mignon-p/NeoBit/doc/neobit-butterfly.jpg

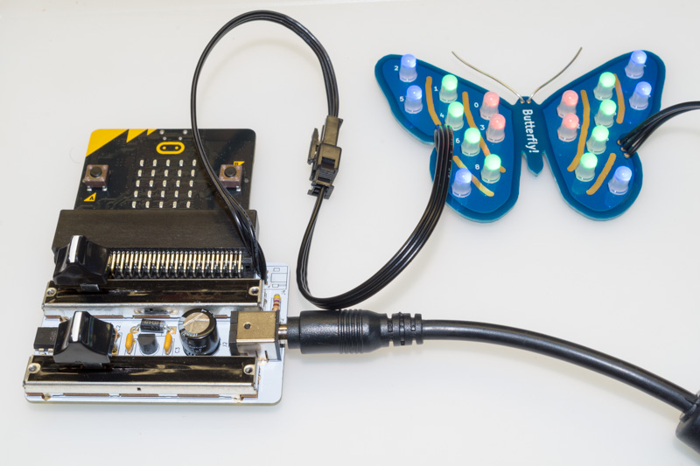
doc/neobit-butterfly.jpg
