mignon-p/NeoBit/doc/schematic.pdf

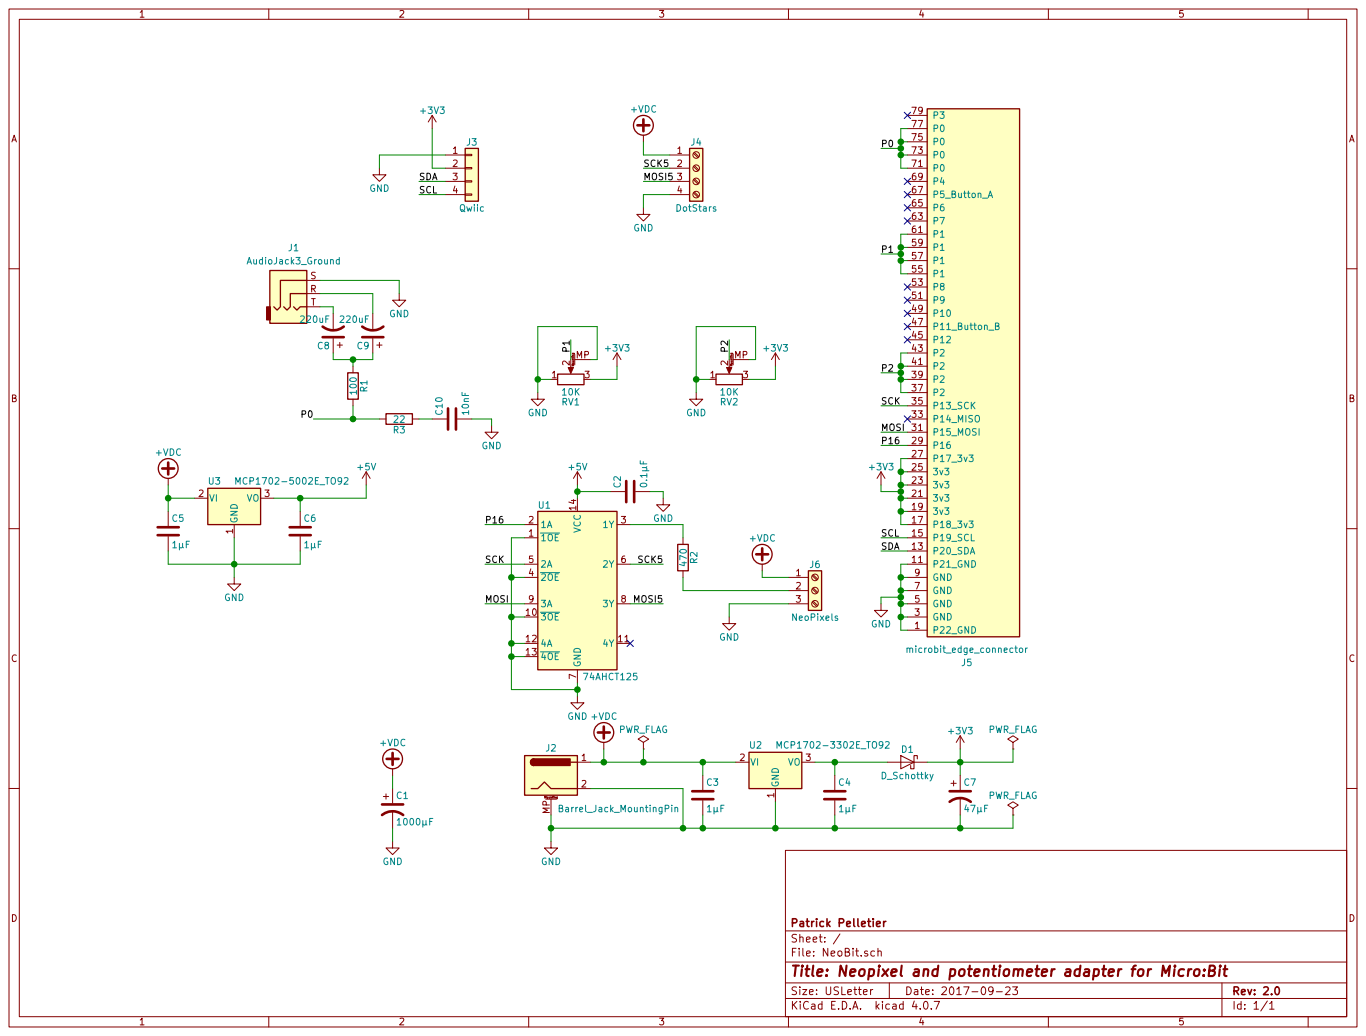
[picture p7: page 1]
