mignon-p/NeoBit/NeoBit.kicad_pcb

## KiCad design NeoBit.kicad_pcb (2018-09-23)

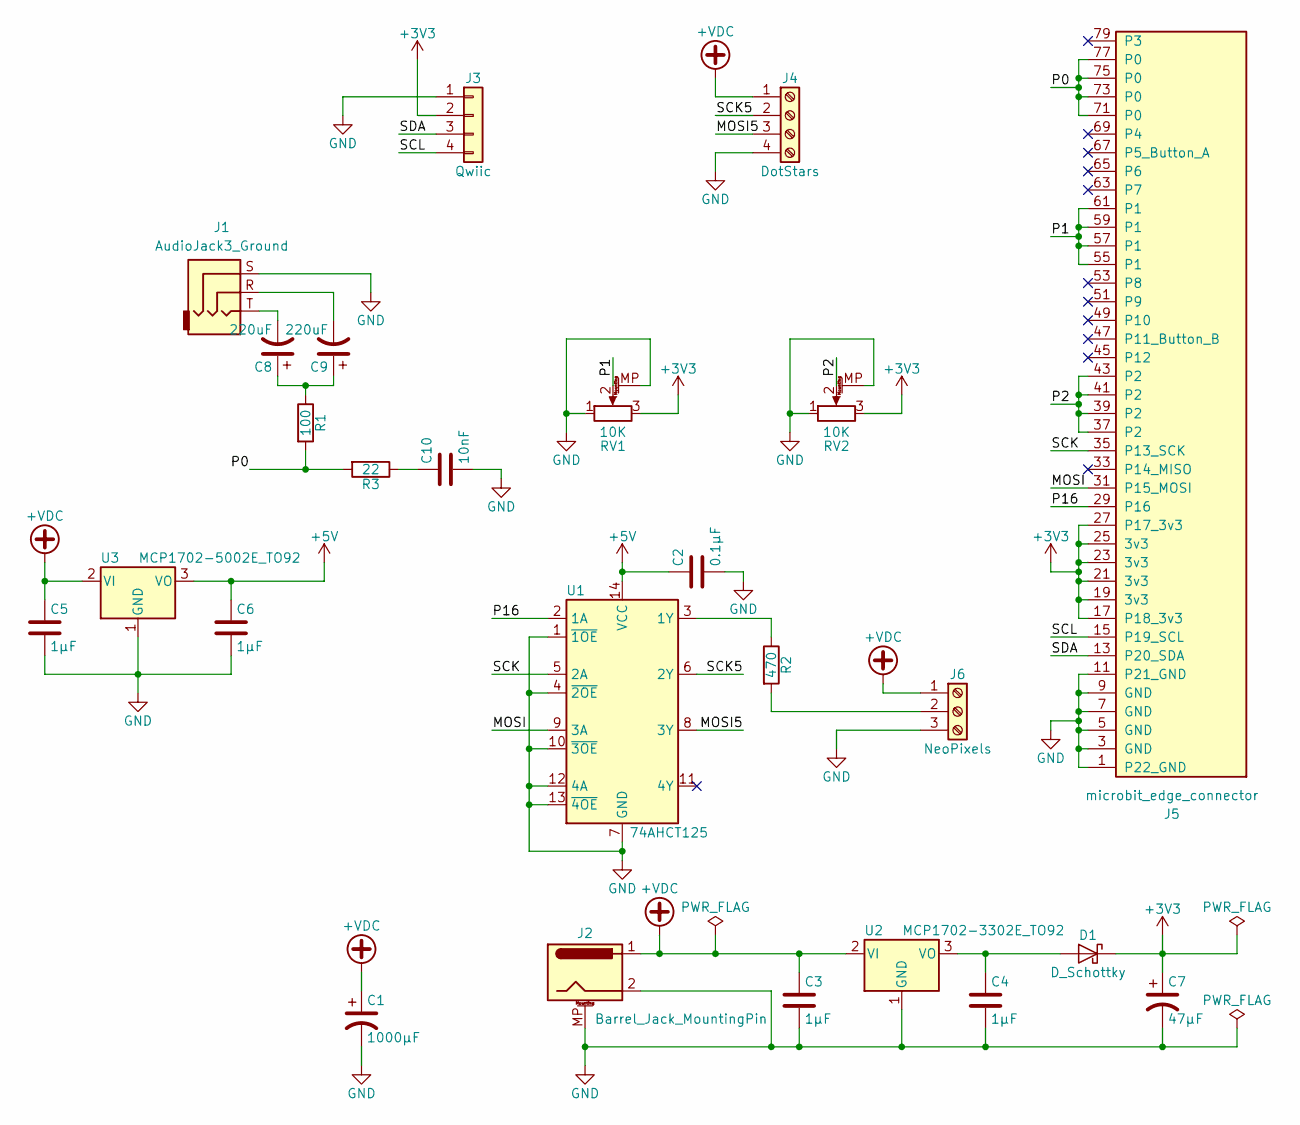
[picture p8: schematic NeoBit.sch, Neopixel and potentiometer adapter for Micro:Bit]

Parts:
C1: 1000µF; CP_Radial_D10.0mm_P5.00mm; MPN 25PX1000MEFCT810X16; Digi-Key_PN 1189-1583-1-ND
C2: 0.1µF; C_Rect_L7.0mm_W2.5mm_P5.00mm; MPN K104K10X7RF5UH5; Digi-Key_PN BC2665CT-ND
C3, C4, C5, C6: 1µF; C_Rect_L7.0mm_W2.5mm_P5.00mm; MPN K105Z20Y5VF5TH5; Digi-Key_PN BC1168CT-ND
C7: 47µF; CP_Radial_D6.3mm_P2.50mm; MPN ECE-A1CKS470; Digi-Key_PN P969-ND
C8, C9: 220uF; CP_Radial_D5.0mm_P2.50mm; MPN UVK1A221MDD1TD; Digi-Key_PN 493-7455-1-ND
C10: 10nF; C_Disc_D3.8mm_W2.6mm_P2.50mm; MPN K103K15X7RF5TL2; Digi-Key_PN BC1078CT-ND
D1: D_Schottky; D_DO-41_SOD81_P7.62mm_Horizontal; MPN 1N5817; Digi-Key_PN 1N5817FSCT-ND
J1: AudioJack3_Ground; SJ1-3533NG; MPN SJ1-3533NG; Digi-Key_PN CP1-3533NG-ND
J2: Barrel_Jack_MountingPin; BarrelJack_CUI_PJ-063AH_Horizontal_CircularHoles; MPN PJ-063AH; Digi-Key_PN CP-063AH-ND
J3: Qwiic; JST_SH_SM04B-SRSS-TB_04x1.00mm_Angled; MPN PRT-14417
J4: DotStars; TerminalBlock_4Ucon_1x04_P3.50mm_Vertical; MPN 1776275-4; Digi-Key_PN A98038-ND
J5: microbit_edge_connector; 4UCON_10156_2x40_P1.27mm_Socket_Horizontal; MPN 3342
J6: NeoPixels; TerminalBlock_4Ucon_1x03_P3.50mm_Vertical; MPN 1776275-3; Digi-Key_PN A98037-ND
R1: 100; R_Axial_DIN0207_L6.3mm_D2.5mm_P2.54mm_Vertical
R2: 470; R_Axial_DIN0207_L6.3mm_D2.5mm_P2.54mm_Vertical; MPN CF14JT470R; Digi-Key_PN CF14JT470RCT-ND
R3: 22; R_Axial_DIN0207_L6.3mm_D2.5mm_P2.54mm_Vertical
RV1, RV2: 10K; Bourns_PTA4543; MPN PTA4553-2015CPB103; Digi-Key_PN PTA4553-2015CPB103-ND
U1: 74AHCT125; DIP-14_W7.62mm; MPN SN74AHCT125N; Digi-Key_PN 296-4655-5-ND
U2: MCP1702-3302E_TO92; TO-92_Inline_Narrow_Oval; MPN MCP1702-3302E/TO; Digi-Key_PN MCP1702-3302E/TO-ND
U3: MCP1702-5002E_TO92; TO-92_Inline_Narrow_Oval

Connections:
+3V3: C7.1, D1.1 (K), J3.2, J5.17 (P18_3v3), J5.19 (3v3), J5.21 (3v3), J5.23 (3v3), J5.25 (3v3), J5.27 (P17_3v3), RV1.3, RV2.3
+5V: C2.1, C6.1, U1.14 (VCC), U3.3 (VO)
+VDC: C1.1, C3.1, C5.1, J2.1, J4.1, J6.1, U2.2 (VI), U3.2 (VI)
/MOSI: J5.31 (P15_MOSI), U1.9 (3A)
/MOSI5: J4.3, U1.8 (3Y)
/P0: J5.71 (P0), J5.73 (P0), J5.75 (P0), J5.77 (P0), R1.2, R3.2
/P1: J5.55 (P1), J5.57 (P1), J5.59 (P1), J5.61 (P1), RV1.2
/P2: J5.37 (P2), J5.39 (P2), J5.41 (P2), J5.43 (P2), RV2.2
/P16: J5.29 (P16), U1.2 (1A)
/SCK: J5.35 (P13_SCK), U1.5 (2A)
/SCK5: J4.2, U1.6 (2Y)
/SCL: J3.4, J5.15 (P19_SCL)
/SDA: J3.3, J5.13 (P20_SDA)
GND: C1.2, C2.2, C3.2, C4.2, C5.2, C6.2, C7.2, C10.2, J1.S, J2.2, J2.MP (MountPin), J3.1, J4.4, J5.1 (P22_GND), J5.3 (GND), J5.5 (GND), J5.7 (GND), J5.9 (GND), J5.11 (P21_GND), J6.3, RV1.1, RV1.MP (MountPin), RV2.1, RV2.MP (MountPin), U1.1 (~1OE), U1.4 (~2OE), U1.7 (GND), U1.10 (~3OE), U1.12 (4A), U1.13 (~4OE), U2.1 (GND), U3.1 (GND)
unnamed: C4.1, D1.2 (A), U2.3 (VO)
unnamed: C8.1, C9.1, R1.1
unnamed: C8.2, J1.T
unnamed: C9.2, J1.R
unnamed: C10.1, R3.1
unnamed: J6.2, R2.2
unnamed: R2.1, U1.3 (1Y)

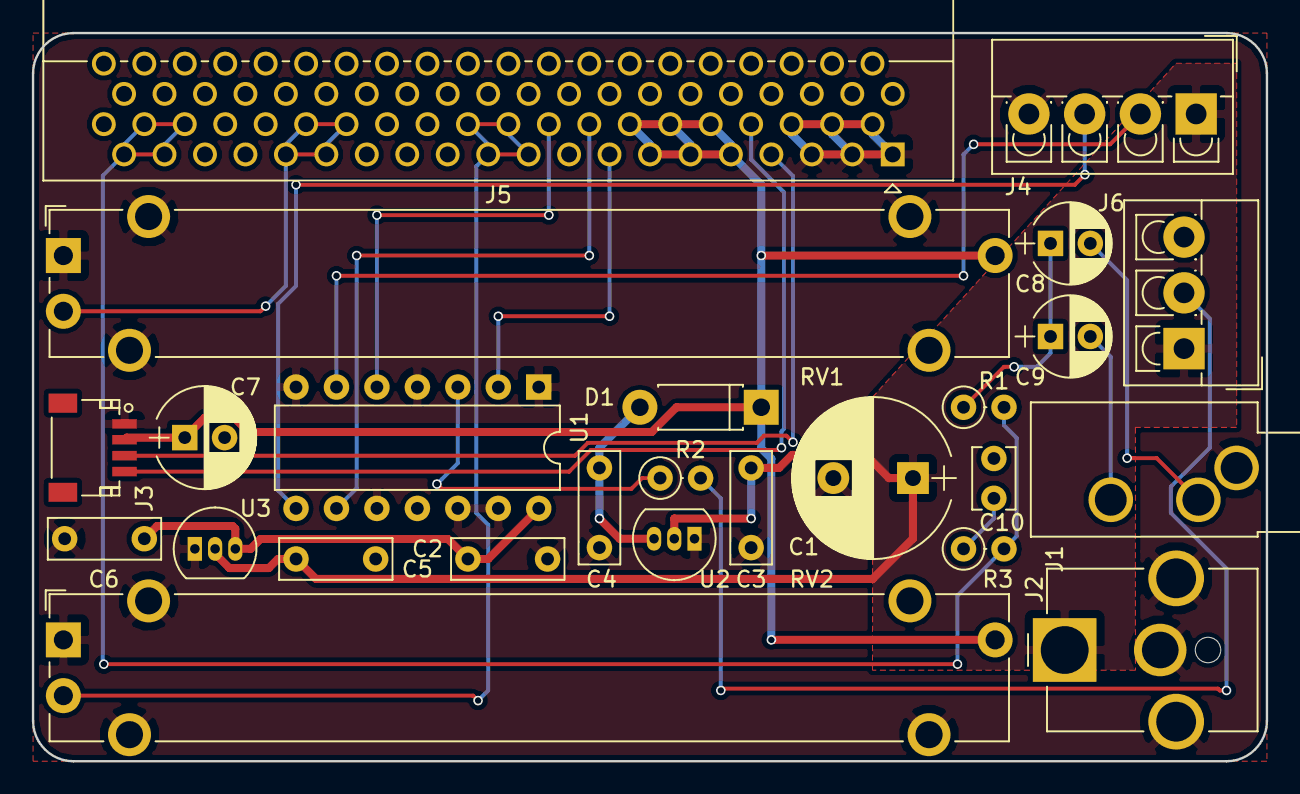
[picture p9: board NeoBit.kicad_pcb from above]

Board: 2 copper layers, 77.5 x 45.7 mm, 25 parts (0 on the bottom side), 21 nets.
