mignon-p/NeoBit/(commit log)

2018-08-30 Initial commit.
    [MicroBitFeather.kicad_pcb, MicroBitFeather.sch]
2018-08-30 Add component libraries.
    [MicroBitFeather.sch]
2018-08-30 Update pin size and fill of feather components.
    [MicroBitFeather.sch]
2018-08-30 Wire up the micro:bit and feather connectors.
    [MicroBitFeather.sch]
2018-08-30 Add connector for NeoPixels.
    [MicroBitFeather.sch]
2018-08-30 Library with a couple other random components.
2018-08-30 Align 74AHCT125 pins to grid.
    [MicroBitFeather.sch]
2018-08-30 Update symbol cache.
    [MicroBitFeather.sch]
2018-08-30 Wired some more things up.
    [MicroBitFeather.sch]
2018-08-30 Add voltage regulator and more.
    [MicroBitFeather.sch]
2018-08-31 Fill in manufacturer part numbers.
    [MicroBitFeather.sch]
2018-08-31 Decrease size of cap on 3.3V supply to 47uF.
    [MicroBitFeather.sch]
2018-08-31 Use correct symbol for microfarads.
    [MicroBitFeather.sch]
2018-08-31 Annotate components.
    [MicroBitFeather.sch]
2018-08-31 Start associating a few footprints.
    [MicroBitFeather.sch]
2018-08-31 Add a couple of footprints.
2018-08-31 Finish footprint associations.
    [MicroBitFeather.sch]
2018-08-31 Started placing footprints.
    [MicroBitFeather.kicad_pcb]
2018-08-31 Place footprints.
    [MicroBitFeather.kicad_pcb]
2018-08-31 Tweaks to footprint placement.
    [MicroBitFeather.kicad_pcb]
2018-08-31 Rounded corners for board outline.
    [MicroBitFeather.kicad_pcb]
2018-08-31 Board outline.
    [MicroBitFeather.kicad_pcb]
2018-08-31 5V wiring.
    [MicroBitFeather.kicad_pcb]
2018-08-31 3V3 wiring.
    [MicroBitFeather.kicad_pcb]
2018-08-31 Some more tracks.
    [MicroBitFeather.kicad_pcb]
2018-08-31 I meant for NeoPixel pin to be P0.
    [MicroBitFeather.kicad_pcb, MicroBitFeather.sch]
2018-08-31 More tracks.
    [MicroBitFeather.kicad_pcb]
2018-08-31 Finish tracks.
    [MicroBitFeather.kicad_pcb]
2018-08-31 Fill GND zones.
    [MicroBitFeather.kicad_pcb]
2018-08-31 Passes DRC now.
    [MicroBitFeather.kicad_pcb]
2018-08-31 Move one wire to help GND routing a little bit.
    [MicroBitFeather.kicad_pcb]
2018-08-31 Some stitching vias should help GND.
    [MicroBitFeather.kicad_pcb]
2018-08-31 One more stitching via.
    [MicroBitFeather.kicad_pcb]
2018-08-31 Add a couple more stiching vias.
    [MicroBitFeather.kicad_pcb]
2018-09-01 I had the pinout for the NeoPixel connector wrong.
    https://cdn.sparkfun.com/datasheets/Prototyping/ACCA-1495.pdf
    [MicroBitFeather.kicad_pcb, MicroBitFeather.sch]
2018-09-01 Add a couple more stitching vias, although perhaps I am getting carried away.
    [MicroBitFeather.kicad_pcb]
2018-09-01 Update to new version of micro:bit edge connector footprint.
    [MicroBitFeather.kicad_pcb]
2018-09-01 NeoBit is based on MicroBitFeather.
    [NeoBit.kicad_pcb, NeoBit.sch]
2018-09-01 Potentiometer with mounting pin.
2018-09-01 Add potentiometers to schematic.
    [NeoBit.sch]
2018-09-01 Put no-connects on most micro:bit pins.
    [NeoBit.sch]
2018-09-01 Footprint for slide potentiometers.
    [NeoBit.sch]
2018-09-01 Remove old components and tracks.
    [NeoBit.kicad_pcb]
2018-09-01 Footprints are mostly positioned.
    [NeoBit.kicad_pcb]
2018-09-01 I don't think we need that cap on 3V3.
    [NeoBit.sch]
2018-09-01 Adjust footprint placement.
    [NeoBit.kicad_pcb]
2018-09-01 Draw board outline.
    [NeoBit.kicad_pcb]
2018-09-01 Position text.
    [NeoBit.kicad_pcb]
2018-09-02 Wire things up.
    [NeoBit.kicad_pcb]
2018-09-02 Fill zones.
    [NeoBit.kicad_pcb]
2018-09-03 Add stuff on back silkscreen.
    [NeoBit.kicad_pcb, NeoBit.sch]
2018-09-03 Add BOM to README.
2018-09-04 Add silkscreen labels for connectors.
    [NeoBit.kicad_pcb]
2018-09-04 Added knob to BOM; reformatted table.
2018-09-04 Generate Gerbers.
    [NeoBit-B.Cu.gbl, NeoBit-B.Mask.gbs, NeoBit-B.SilkS.gbo, NeoBit-Edge.Cuts.gm1, NeoBit-F.Cu.gtl, NeoBit-F.Mask.gts, NeoBit-F.SilkS.gto, NeoBit-NPTH.drl]
2018-09-08 Add PDF of schematic.
2018-09-16 Links to order board, and view schematic and PCB.
2018-09-20 Added 5V regulator.
    [NeoBit.sch]
2018-09-20 Screw terminals for NeoPixels and DotStars.
    [NeoBit.sch]
2018-09-20 Add qwiic connector.
    [NeoBit.sch]
2018-09-20 Put audio jack on P0; move NeoPixels to P16.
    [NeoBit.sch]
2018-09-21 Add footprint for CUI SJ1-3533NG audio jack.
2018-09-21 Annotate schematic.
    [NeoBit.sch]
2018-09-21 Don't need this power flag.
    [NeoBit.sch]
2018-09-21 Associate some footprints.
    [NeoBit.sch]
2018-09-21 Add terminal block footprints.
2018-09-21 Associate terminal block footprints.
    [NeoBit.sch]
2018-09-21 Roughly position new footprints.
    [NeoBit.kicad_pcb]
2018-09-21 Change some part numbers.
    [NeoBit.sch]
2018-09-21 Update audio jack footprint to have pins T, R, and S.
    [NeoBit.kicad_pcb]
2018-09-21 Add level shifting on DotStar pins.
    [NeoBit.sch]
2018-09-21 Use a higher-voltage capacitor.
    [NeoBit.sch]
2018-09-22 Part numbers for terminal blocks.
    [NeoBit.sch]
2018-09-22 Add 47uF capacitor on 3V3 supply.
    [NeoBit.sch]
2018-09-22 Add capacitor and move labels.
    [NeoBit.kicad_pcb]
2018-09-22 Extend zones and board outline.
    [NeoBit.kicad_pcb]
2018-09-22 Change shape of +V zone.
    [NeoBit.kicad_pcb]
2018-09-22 Get +V zone on correct net.
    [NeoBit.kicad_pcb]
2018-09-22 Draw a few tracks.
    [NeoBit.kicad_pcb]
2018-09-22 Added some more tracks.
    [NeoBit.kicad_pcb]
2018-09-22 Finished wiring power tracks.
    [NeoBit.kicad_pcb]
2018-09-22 I think I've routed all the tracks.
    [NeoBit.kicad_pcb]
2018-09-22 Filled zones; passed DRC.
    [NeoBit.kicad_pcb]
2018-09-22 Start moving some silkscreen around.
    [NeoBit.kicad_pcb]
2018-09-22 Finish adding silkscreen.
    [NeoBit.kicad_pcb]
2018-09-23 Use new footprint for micro:bit edge connector.
    [NeoBit.kicad_pcb, NeoBit.sch]
2018-09-23 Add filter to audio output.
    [NeoBit.sch]
2018-09-23 Cram audio filter into PCB.
    [NeoBit.kicad_pcb]
2018-09-23 I had the 220uF capacitors backwards.
    [NeoBit.sch]
2018-09-23 Finish wiring up PCB.
    [NeoBit.kicad_pcb]
2018-09-23 Passing DRC now.
    [NeoBit.kicad_pcb]
2018-09-23 Call this 2.0 instead of 1.1; not software compatible.
    NeoPixels changed pin from P0 to P16.
    [NeoBit.kicad_pcb, NeoBit.sch]
2018-09-23 Regenerate Gerbers.
    [NeoBit-B.Cu.gbl, NeoBit-B.Mask.gbs, NeoBit-B.SilkS.gbo, NeoBit-Edge.Cuts.gm1, NeoBit-F.Cu.gtl, NeoBit-F.Mask.gts, NeoBit-F.SilkS.gto, NeoBit-NPTH.drl]
2018-09-23 Add part numbers for resistors.
    [NeoBit.sch]
2018-09-23 Part number for 5V regulator.
    [NeoBit.sch]
2018-09-25 Update schematic PDF for version 2.0.
2018-09-29 Update BOM in README.
2018-10-04 Power line is not necessarily 5V.
2018-10-05 Label the connectors in the neo:bit photo.
2021-10-22 Link to kicad.org
    https://forum.kicad.info/t/warning-avoid-all-links-to-kicad-pcb-org-use-kicad-org/31521
